FireMarshmellow/diy-smart-blood-pressure-monitor/docs/example_frame.png

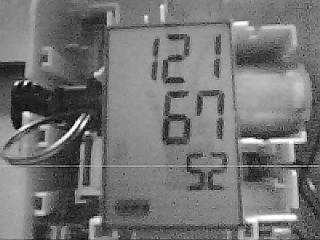
docs/example_frame.png
