FireMarshmellow/diy-smart-blood-pressure-monitor/cad/Bpm_Cam_Arm.step

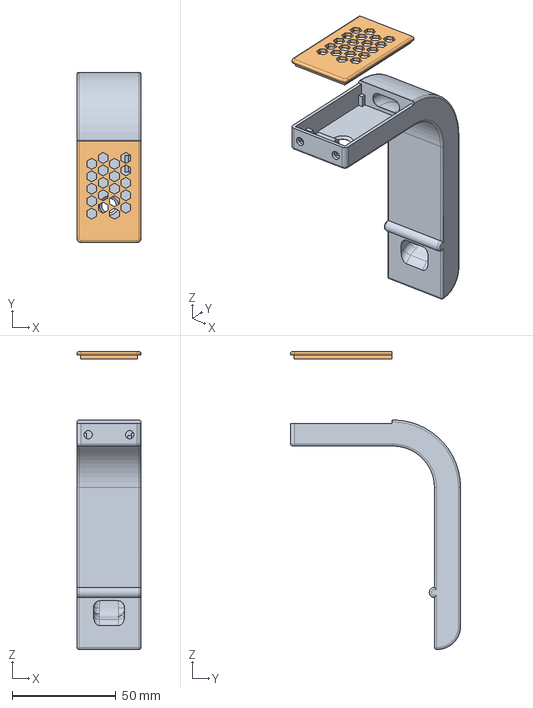
[picture p3: CAD file, 2026-10-15]
cad/Bpm_Cam_Arm.step
31.0 x 82.0 x 143.6 mm
