FireMarshmellow/diy-smart-blood-pressure-monitor/3_reader/bp_reader/secrets.example.h

// Copy this file to secrets.h (same folder) and fill it in.
// secrets.h is git-ignored, so none of this ends up on GitHub.

#define WIFI_SSID "your-wifi-name"
#define WIFI_PASS "your-wifi-password"

#define SEND_URL  "http://192.168.1.10:8123/api/webhook/blood-pressure"
#define SEND_AUTH ""            // e.g. "Bearer abc123", or leave empty

#define OTA_PASS  "change-me"
