FireMarshmellow/diy-smart-blood-pressure-monitor/(commit log)

2026-10-15 DIY smart blood pressure monitor: camera preview, digit mapper and reader
2026-10-15 Add camera arm STEP file
    [Bpm_Cam_Arm.step]
